Vino4/PED/Sketches/Battery to ESC and Edison.png

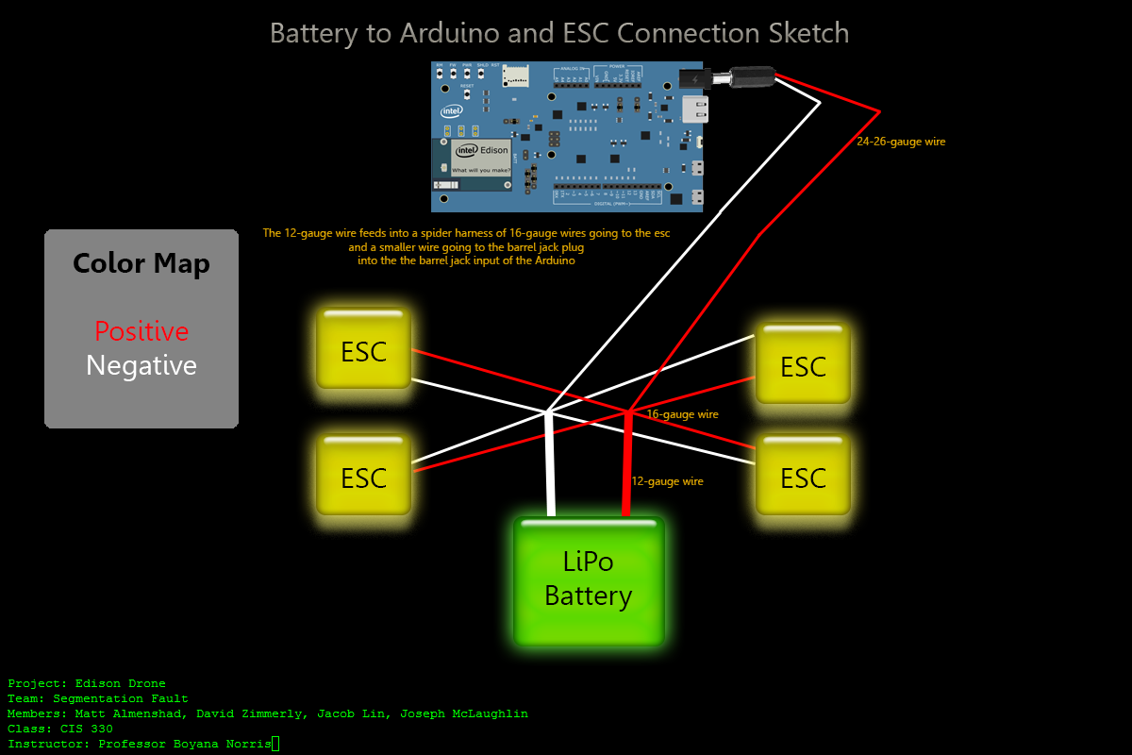
Sketches/Battery to ESC and Edison.png
