Vino4/PED/Sketches/ESC to Edison2.png

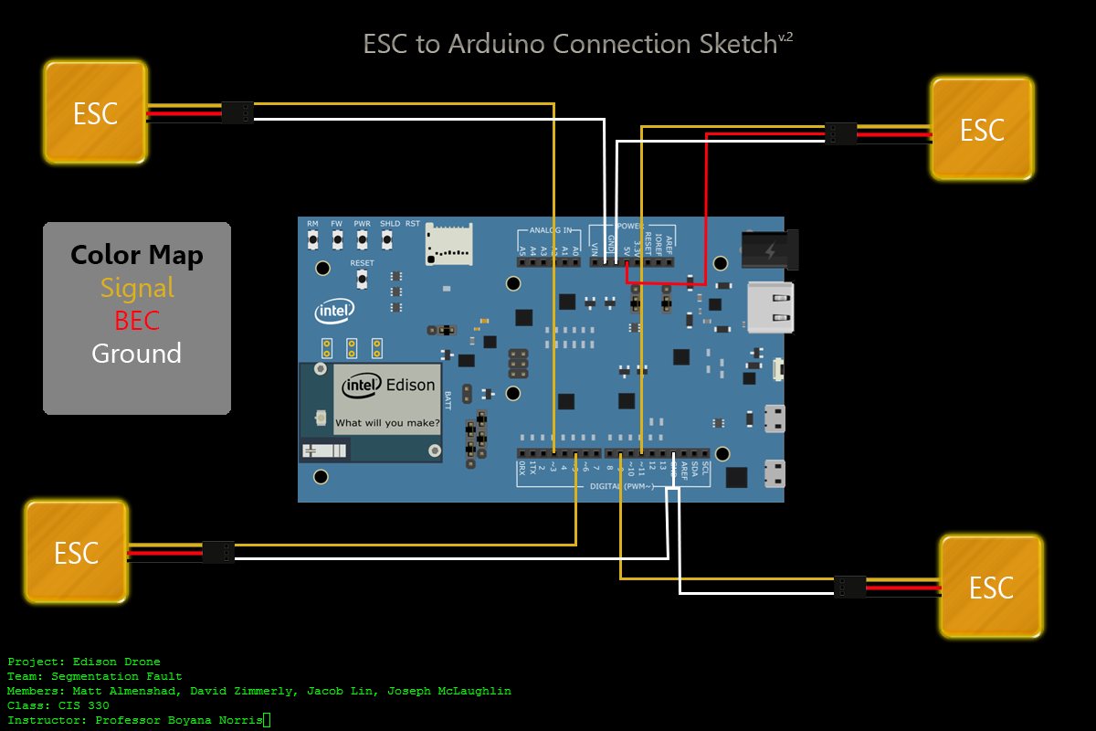
Sketches/ESC to Edison2.png
