Vino4/PED/Sketches/ESC to Edison.png

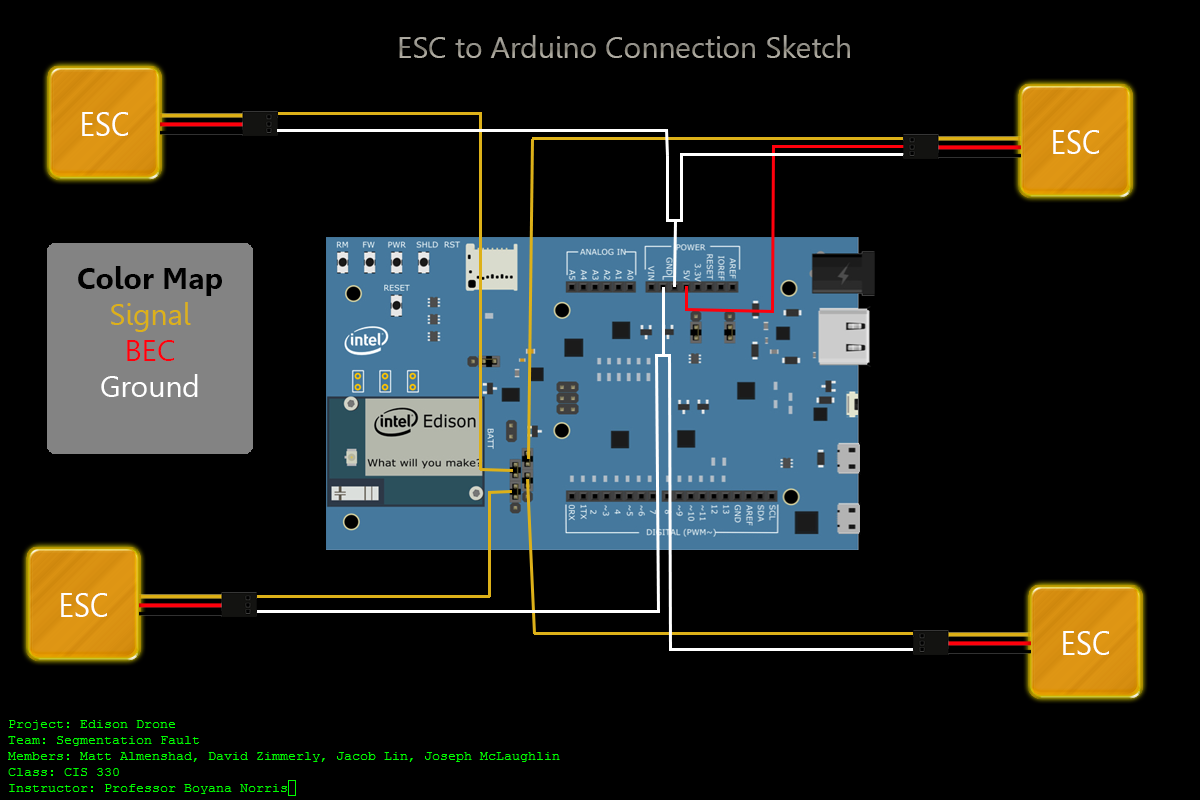
Sketches/ESC to Edison.png
