Vino4/PED/Sketches/ESCtoPCA_bb.png

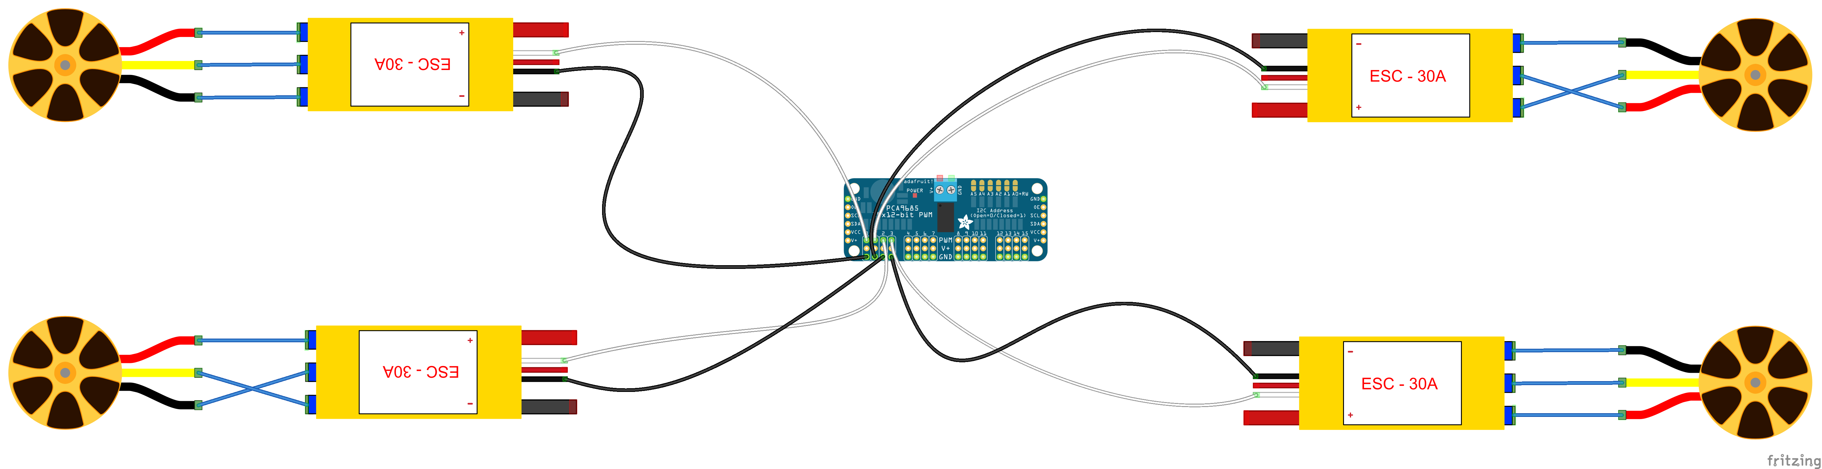
Sketches/ESCtoPCA_bb.png
