Vino4/PED/Sketches/PCA9685-MPU6050-Edison2_bb.png

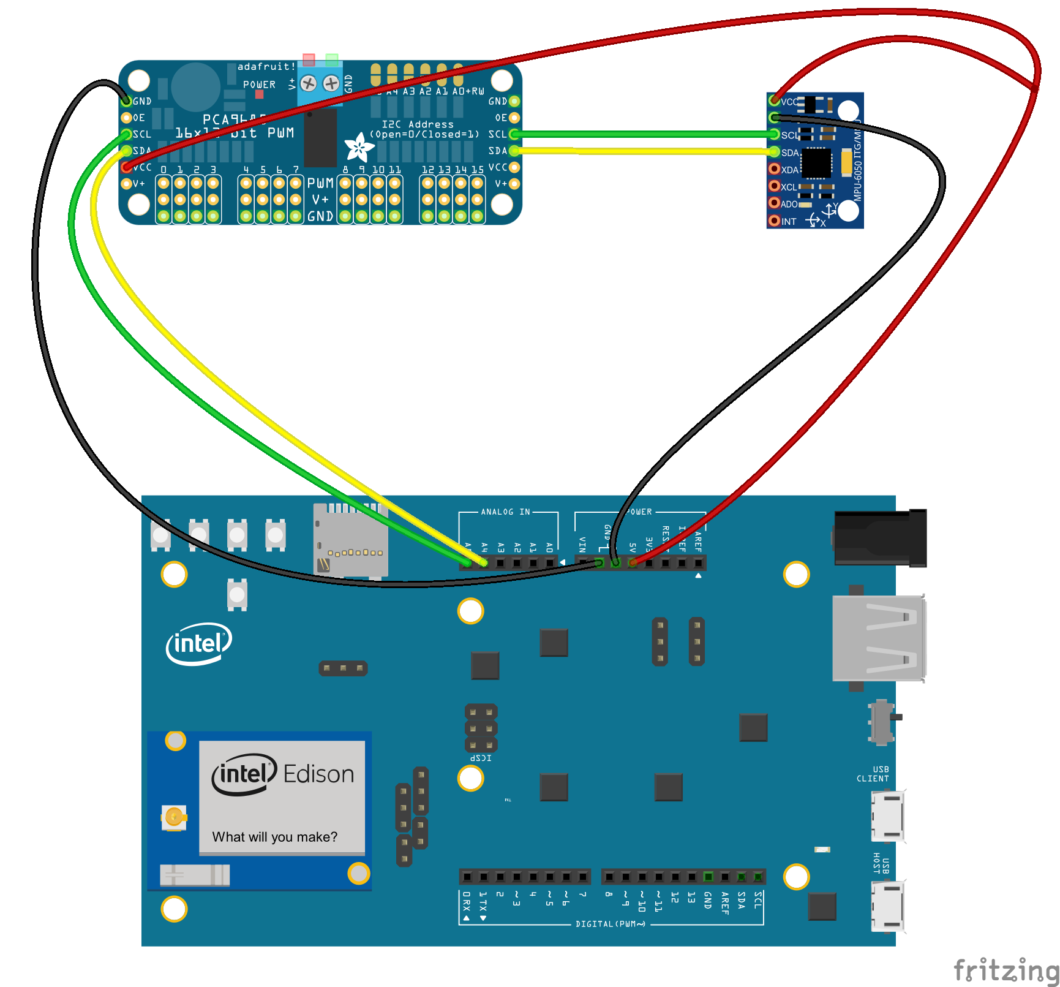
Sketches/PCA9685-MPU6050-Edison2_bb.png
