Vino4/PED/Sketches/PCA9685-MPU6050-Edison_bb.png

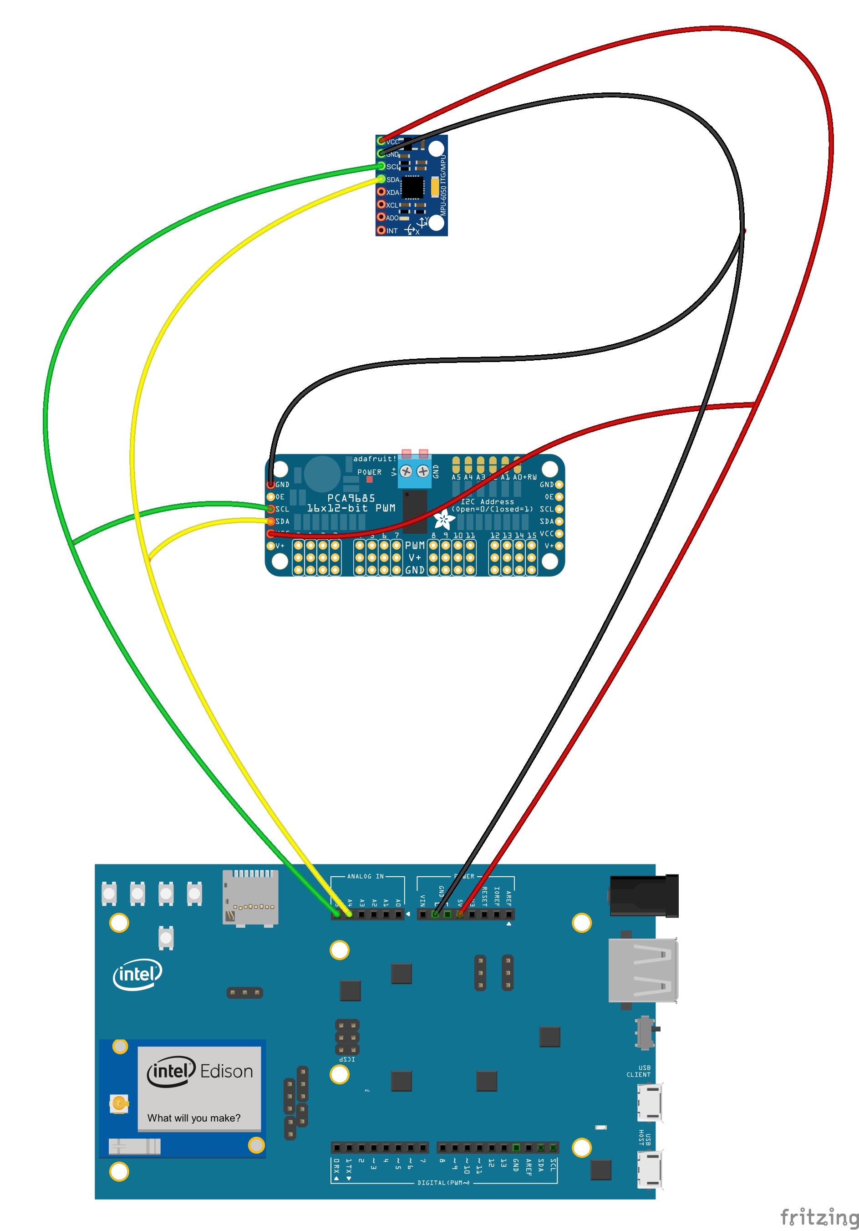
Sketches/PCA9685-MPU6050-Edison_bb.png
