Vino4/PED/Sketches/PED_bb.png

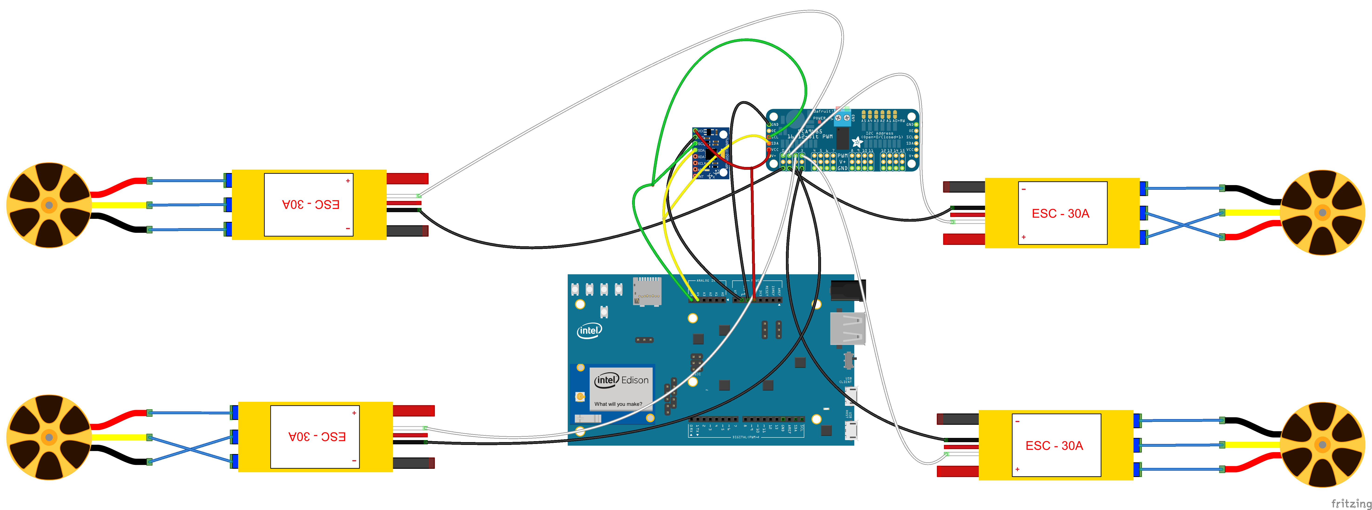
Sketches/PED_bb.png
