Vino4/PED/Sketches/PEDnew_bb.png

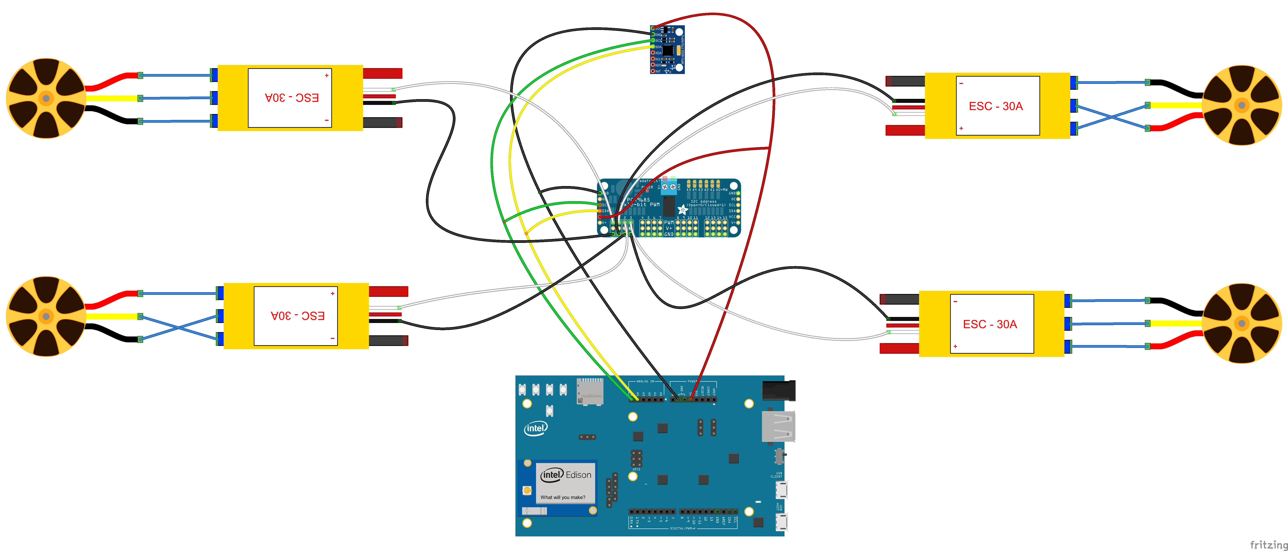
Sketches/PEDnew_bb.png
