Vino4/PED/Sketches/PEDold_bb.png

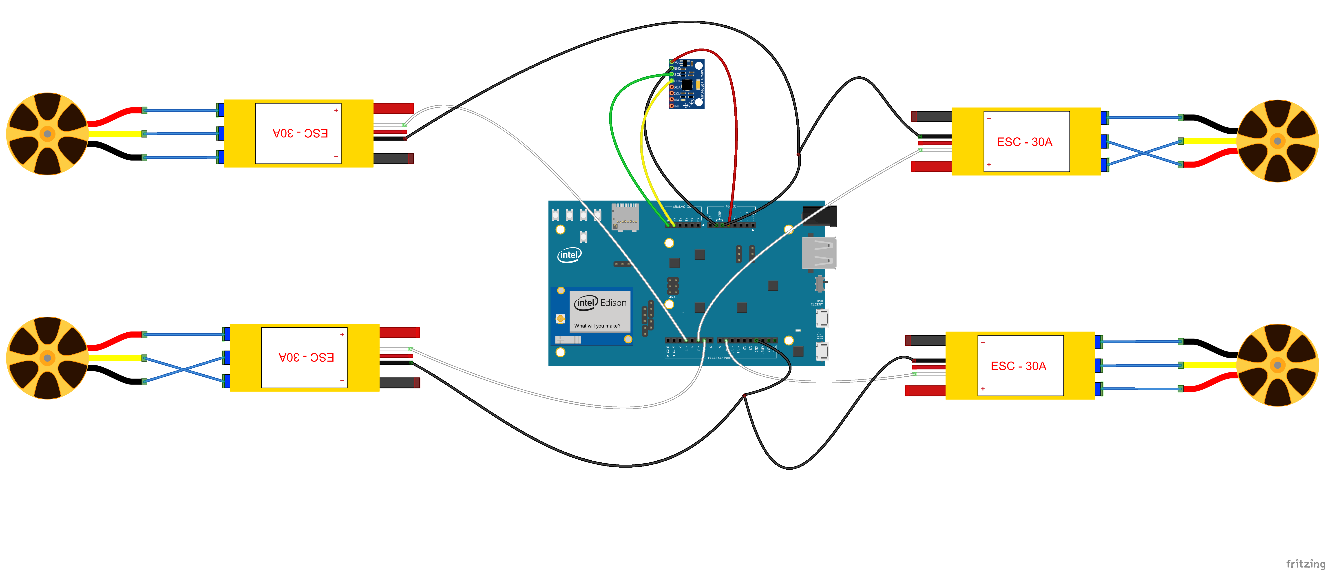
Sketches/PEDold_bb.png
